calsokk/Sound_LED_PCB/sound_led_project.kicad_pcb

## KiCad design sound_led_project.kicad_pcb (2024-12-28)

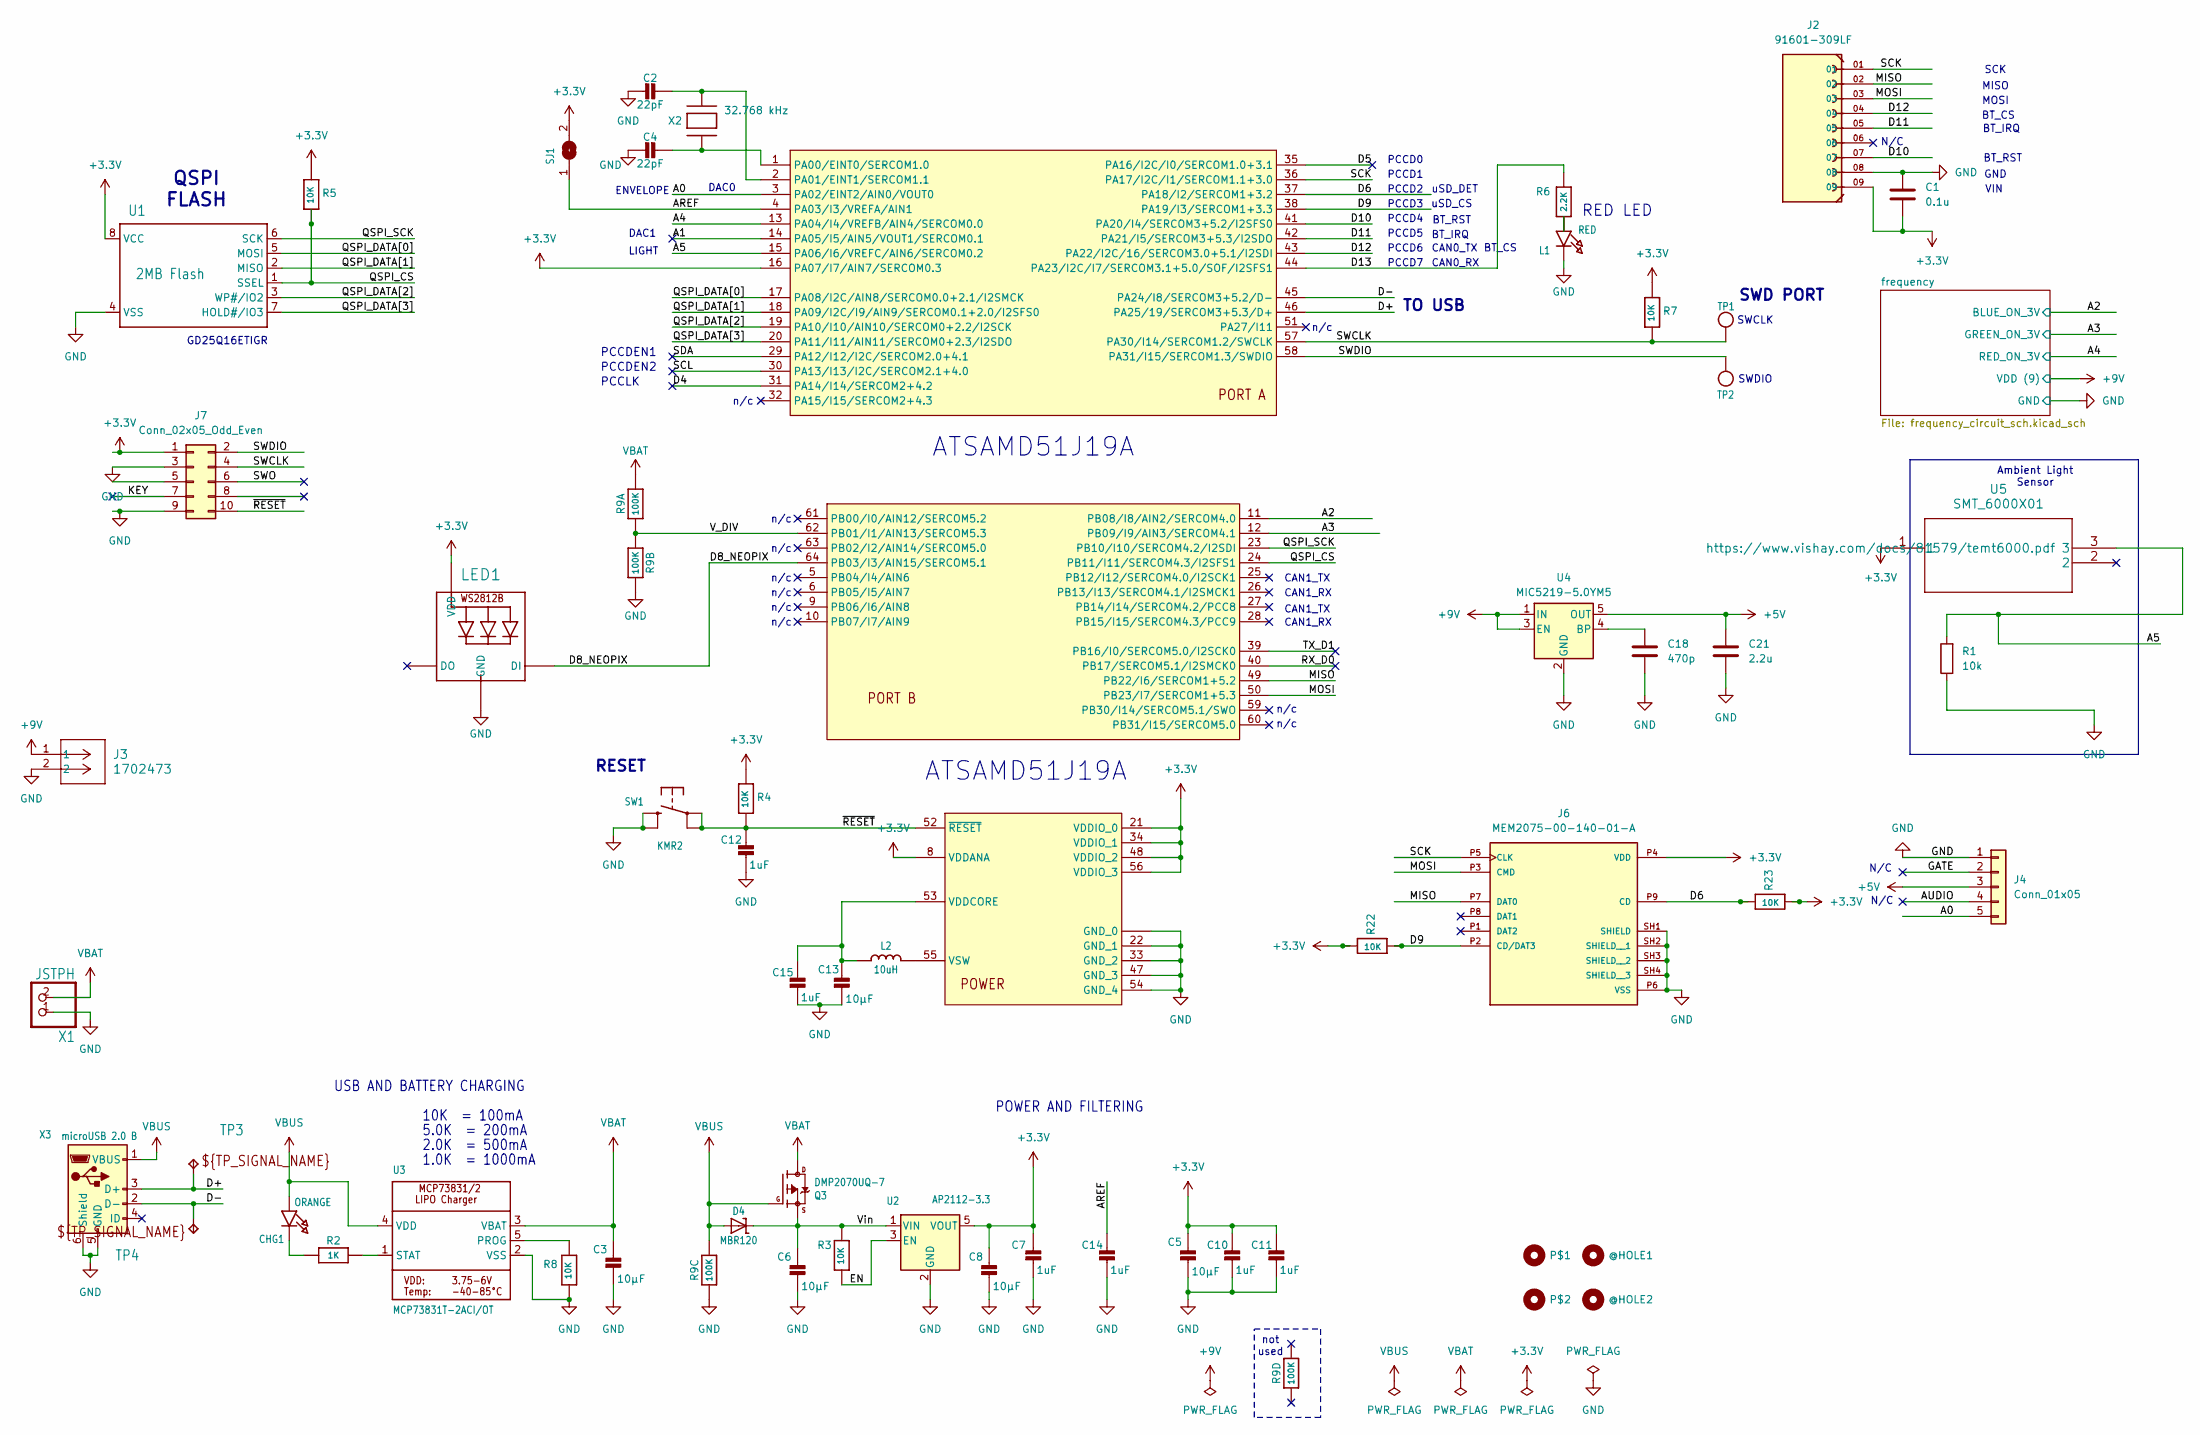
[picture p3: schematic sound_led_project.kicad_sch, feather M4 express]

Parts:
@HOLE1, @HOLE2: MountingHole; MountingHole_2.5mm
C1: 0.1u; C_0402_1005Metric_Pad0.74x0.62mm_HandSolder; Mfr P/N CL05B104KP5NNNC
C2, C4: 22pF; 0603-NO; Mfr P/N C0603C220K4GAC7867
C3, C5, C6, C8, C13: 10µF; 0805-NO; Mfr P/N CL21A106KOQNNNE
C7, C10, C11, C12, C14, C15: 1uF; C_0603_1608Metric_Pad1.08x0.95mm_HandSolder; Mfr P/N CC0603KRX7R7BB105
C18: 470p; C_0402_1005Metric_Pad0.74x0.62mm_HandSolder; Mfr P/N GRM155R71H471KA01D
C21: 2.2u; C_0201_0603Metric; Mfr P/N CL10A225KO8NNNC
CHG1: ORANGE; CHIPLED_0805_NOOUTLINE; Mfr P/N B1701UD--20D000414U1930
D4: MBR120; SOD-123; Mfr P/N MBR120LSFT1G
J2: 91601-309LF; AMPHENOL_91601-309LF; PARTREV AJ
J3: 1702473; Mfr P/N 1702473
J4: Conn_01x05; GCT_BG125-05-A-1-1-0440-N-D-TOP; Mfr P/N BG125-05-A-1-1-0440-N-D
J6: MEM2075-00-140-01-A; GCT_MEM2075-00-140-01-A; PARTREV A
J7: Conn_02x05_Odd_Even; AMPHENOL_20021521-00010T4LF; Mfr P/N 20021521-00010T4LF
L1: RED; CHIPLED_0805_NOOUTLINE; Mfr P/N LTST-S220KRKT
L2: 10uH; INDUCTOR_1007; Mfr P/N LSQEA251818T100K
LED1: WS2812B3535; LED3535; Mfr P/N SK6812MINI
P$1, P$2: MountingHole; MOUNTINGHOLE_2.5_PLATED
Q3: DMP2070UQ-7; SOT23-R; Mfr P/N DMP2070UQ-7
R1: 10k; R_0805_2012Metric_Pad1.20x1.40mm_HandSolder; Mfr P/N ERJ-U06D1002V
R2: 1K; 0603-NO; Mfr P/N MCT06030C1001FP500
R3, R4, R5, R7, R8, R22, R23: 10K; 0603-NO; Mfr P/N RNCP0603FTD10K0
R6: 2.2K; 0603-NO; Mfr P/N CRGH0603F2K2
R9: 100K; R_Array_Convex_4x0603; Mfr P/N CAY16-1003F4LF
SJ1: SOLDERJUMPERCLOSED; SOLDERJUMPER_CLOSEDWIRE
SW1: KMR2; BTN_KMR2_4.6X2.8; Mfr P/N KMR241NG ULC LFS
TP1, TP2: TESTPOINTROUND1.5MM; TESTPOINT_ROUND_1.5MM
TP3, TP4: B1,27_385
U1: 2MB Flash; SOIC-8_3.9x4.9mm_P1.27mm; Mfr P/N GD25Q16ETIGR
U2: AP2112-3.3; SOT-23-5; Mfr P/N AP2112K-3.3TRG1
U3: MCP73831T-2ACI/OT; SOT23-5; Mfr P/N MCP73831T-2ATI/OT
U4: MIC5219-5.0YM5; SOT-23-5; Mfr P/N MIC5219-5.0YM5-TR
U5: SMT_6000X01; TEMT6000X01; Mfr P/N TEMT6000X01
U$1: ATSAMD51J19A-AUT; TQFP-64_10x10mm_P0.5mm; Mfr P/N ATSAMD51J19A-AUT
X1: JSTPH; JST_PH_S2B-PH-SM4-TB_1x02-1MP_P2.00mm_Horizontal; Mfr P/N S2B-PH-SM4-TB
X2: 32.768 kHz; XTAL3215; Mfr P/N STDMUA17-32.768K
X3: microUSB 2.0 B; USB_Micro-B_Amphenol_10118194_Horizontal; Mfr P/N 10118194-0001LF

Connections:
+3.3V: C1.2, C5.1, C7.1, C8.1, C10.1, C11.1, J2.09, J6.P4 (VDD), J7.1, LED1.2 (VDD), R4.1, R5.1, R7.1, R22.1, R23.2, SJ1.2, U1.8 (VCC), U2.5 (VOUT), U5.1, U$1.8 (VDDANA), U$1.16 (PA07/I7/AIN7/SERCOM0.3), U$1.21 (VDDIO_0), U$1.34 (VDDIO_1), U$1.48 (VDDIO_2), U$1.56 (VDDIO_3)
+5V: C21.1, J4.3, U4.5 (OUT)
+9V: J3.1, U4.1 (IN), U4.3 (EN); also elsewhere on the board
/A0: J4.5, U$1.3 (PA02/EINT2/AIN0/VOUT0)
/A1: U$1.14 (PA05/I5/AIN5/VOUT1/SERCOM0.1)
/A2: U$1.11 (PB08/I8/AIN2/SERCOM4.0); also elsewhere on the board
/A3: U$1.12 (PB09/I9/AIN3/SERCOM4.1); also elsewhere on the board
/A4: U$1.13 (PA04/I4/VREFB/AIN4/SERCOM0.0); also elsewhere on the board
/A5: R1.2, U5.3, U$1.15 (PA06/I6/VREFC/AIN6/SERCOM0.2)
/AREF: C14.1, SJ1.1, U$1.4 (PA03/I3/VREFA/AIN1)
/AUDIO: J4.4
/D4: U$1.31 (PA14/I14/SERCOM2+4.2)
/D5: U$1.35 (PA16/I2C/I0/SERCOM1.0+3.1)
/D6: J6.P9 (CD), R23.1, U$1.37 (PA18/I2/SERCOM1+3.2)
/D8_NEOPIX: LED1.1 (DI), U$1.64 (PB03/I3/AIN15/SERCOM5.1)
/D9: J6.P2 (CD/DAT3), R22.2, U$1.38 (PA19/I3/SERCOM1+3.3)
/D10: J2.07, U$1.41 (PA20/I4/SERCOM3+5.2/I2SFS0)
/D11: J2.05, U$1.42 (PA21/I5/SERCOM3+5.3/I2SDO)
/D12: J2.04, U$1.43 (PA22/I2C/16/SERCOM3.0+5.1/I2SDI)
/D13: R6.1, U$1.44 (PA23/I2C/I7/SERCOM3.1+5.0/SOF/I2SFS1)
/D+: TP3.TP, U$1.46 (PA25/19/SERCOM3+5.3/D+), X3.3 (D+)
/D-: TP4.TP, U$1.45 (PA24/I8/SERCOM3+5.2/D-), X3.2 (D-)
/EN: R3.2, U2.3 (EN)
/GATE: J4.2
/KEY: J7.7
/MISO: J2.02, J6.P7 (DAT0), U$1.49 (PB22/I6/SERCOM1+5.2)
/MOSI: J2.03, J6.P3 (CMD), U$1.50 (PB23/I7/SERCOM1+5.3)
/QSPI_CS: R5.2, U1.1 (SSEL), U$1.24 (PB11/I11/SERCOM4.3/I2SFS1)
/QSPI_DATA[0]: U1.5 (MOSI), U$1.17 (PA08/I2C/AIN8/SERCOM0.0+2.1/I2SMCK)
/QSPI_DATA[1]: U1.2 (MISO), U$1.18 (PA09/I2C/I9/AIN9/SERCOM0.1+2.0/I2SFS0)
/QSPI_DATA[2]: U1.3 (WP#/IO2), U$1.19 (PA10/I10/AIN10/SERCOM0+2.2/I2SCK)
/QSPI_DATA[3]: U1.7 (HOLD#/IO3), U$1.20 (PA11/I11/AIN11/SERCOM0+2.3/I2SDO)
/QSPI_SCK: U1.6 (SCK), U$1.23 (PB10/I10/SERCOM4.2/I2SDI)
/RX_D0: U$1.40 (PB17/SERCOM5.1/I2SMCK0)
/SCK: J2.01, J6.P5 (CLK), U$1.36 (PA17/I2C/I1/SERCOM1.1+3.0)
/SCL: U$1.30 (PA13/I13/I2C/SERCOM2.1+4.0)
/SDA: U$1.29 (PA12/I12/I2C/SERCOM2.0+4.1)
/SWCLK: J7.4, R7.2, TP1.P$1, U$1.57 (PA30/I14/SERCOM1.2/SWCLK)
/SWDIO: J7.2, TP2.P$1, U$1.58 (PA31/I15/SERCOM1.3/SWDIO)
/SWO: J7.6
/TX_D1: U$1.39 (PB16/I0/SERCOM5.0/I2SCK0)
/V_DIV: R9.1, R9.2 (1), U$1.62 (PB01/I1/AIN13/SERCOM5.3)
/Vin: C6.1, D4.C, Q3.2 (S), R3.1, U2.1 (VIN)
/~RESET: C12.1, J7.10, R4.2, SW1.A, SW1.A' (P1), U$1.52 (~RESET)
GND: C1.1, C2.2, C3.2, C4.2, C5.2, C6.2, C7.2, C8.2, C10.2, C11.2, C12.2, C13.2, C14.2, C15.2, C18.2, C21.2, J2.08, J3.2, J4.1, J6.P6 (VSS), J6.SH1 (SHIELD), J6.SH2 (SHIELD__1), J6.SH3 (SHIELD__2), J6.SH4 (SHIELD__3), J7.3, J7.9, L1.C, LED1.4 (GND), R1.1, R8.2, R9.3 (1), R9.7 (2), SW1.B (S), SW1.B' (S1), U1.4 (VSS), U2.2 (GND), U3.2 (VSS), U4.2 (GND), U$1.7 (GND_0), U$1.22 (GND_1), U$1.33 (GND_2), U$1.47 (GND_3), U$1.54 (GND_4), X1.1, X3.5 (GND), X3.6 (Shield); also elsewhere on the board
unnamed: CHG1.C, R2.1
unnamed: L1.A, R6.2
unnamed: C13.1, C15.1, L2.P$1 (1), U$1.53 (VDDCORE)
unnamed: L2.P$2 (2), U$1.55 (VSW)
unnamed: R8.1, U3.5 (PROG)
unnamed: R2.2, U3.1 (STAT)
unnamed: C18.1, U4.4 (BP)
unnamed: C4.1, U$1.1 (PA00/EINT0/SERCOM1.0), X2.P$1
unnamed: C2.1, U$1.2 (PA01/EINT1/SERCOM1.1), X2.P$2
VBAT: C3.1, Q3.3 (D), R9.8 (2), U3.3 (VBAT), X1.2
VBUS: CHG1.A, D4.A, Q3.1 (G), R9.6 (2), U3.4 (VDD), X3.1 (VBUS)

Notes on the sheet:
n/c
MISO
SCK
SWCLK
ATSAMD51J19A
USB AND BATTERY CHARGING
PCCD6
Ambient Light Sensor
RED LED
DAC1
CAN0_TX
PCCLK
SWDIO
PCCD5
10K = 100mA
BT_RST
CAN1_TX
TO USB
N/C
PCCD3
5.0K = 200mA
uSD_CS
uSD_DET
PCCD2
GD25Q16ETIGR
1.0K = 1000mA
2.0K = 500mA
GND
BT_CS
PCCD1
CAN1_RX
DAC0
LIGHT
VIN
MOSI
CAN0_RX
PCCD0
ENVELOPE
PCCD7
QSPI FLASH
PCCDEN1
BT_IRQ
SWD PORT
RESET
POWER AND FILTERING
PCCDEN2
not used
PCCD4

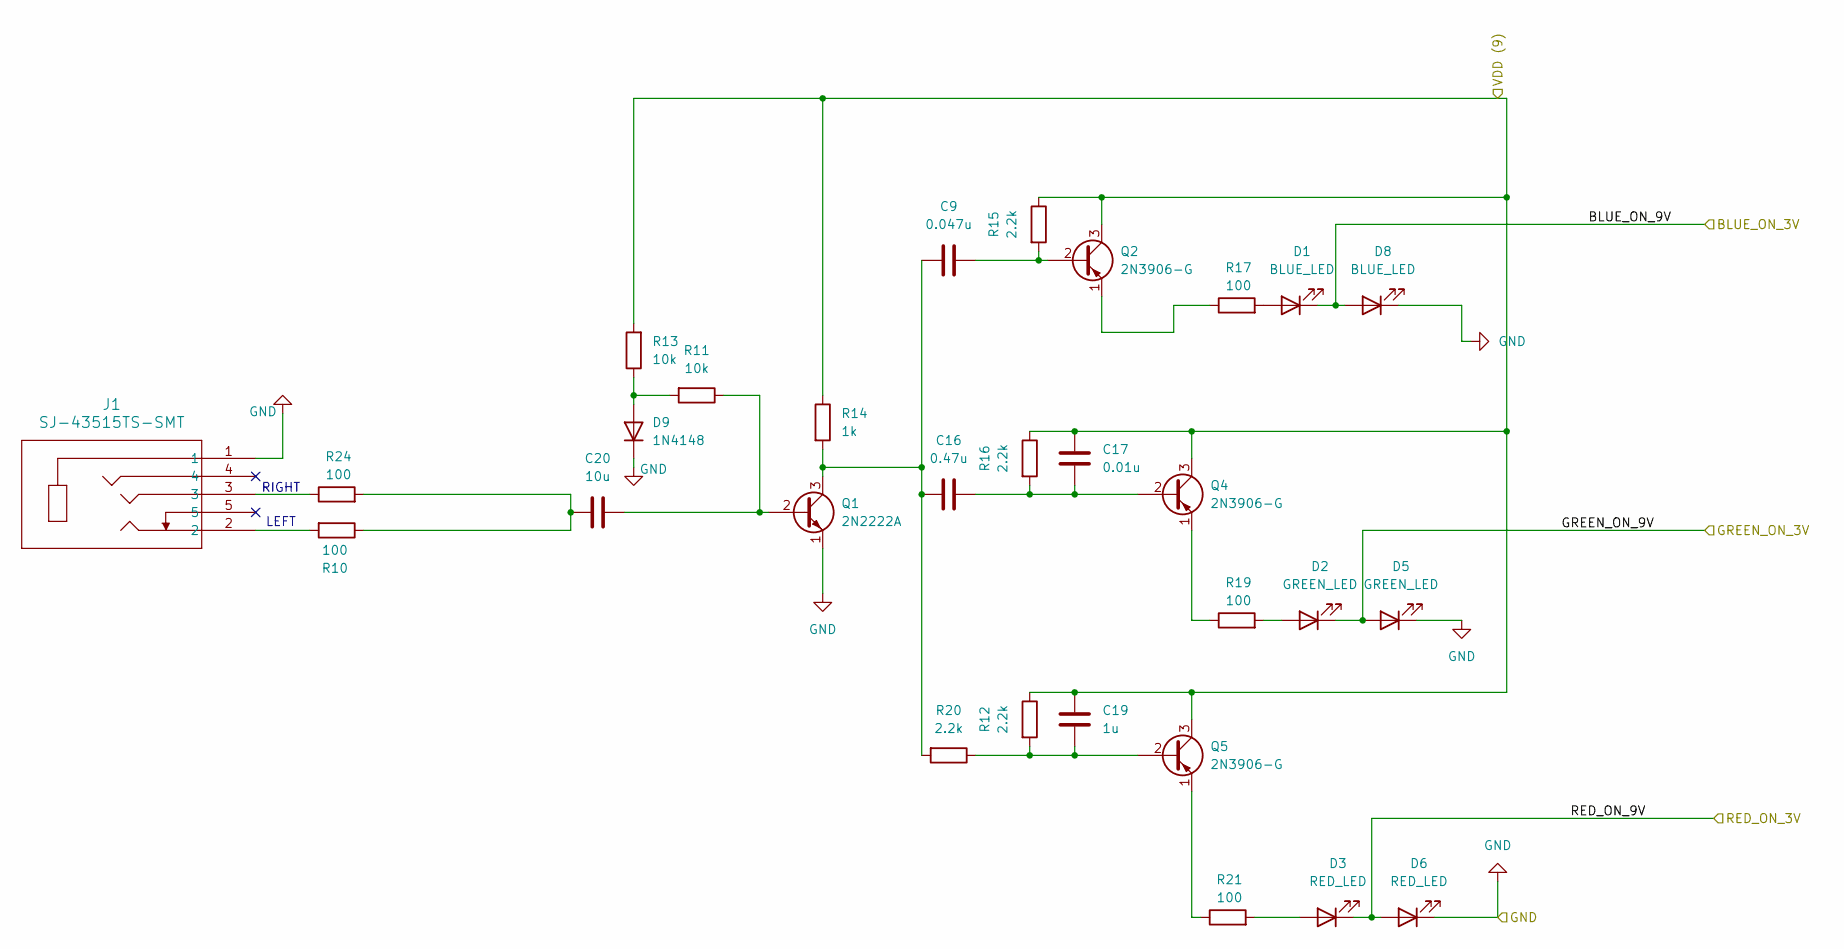
[picture p4: schematic frequency_circuit_sch.kicad_sch]

Parts:
C9: 0.047u; C_0402_1005Metric_Pad0.74x0.62mm_HandSolder; Mfr P/N GRM155R71E473KA88D
C16: 0.47u; C_0805_2012Metric_Pad1.18x1.45mm_HandSolder; Mfr P/N CL21B474KBFNNNG
C17: 0.01u; C_0201_0603Metric_Pad0.64x0.40mm_HandSolder; Mfr P/N GMD033R61A103KA01D
C19: 1u; C_0402_1005Metric_Pad0.74x0.62mm_HandSolder; Mfr P/N MAASL105CD7105MFCA01
C20: 10u; C_0805_2012Metric_Pad1.18x1.45mm_HandSolder; Mfr P/N CL21A106KOQNNNE
D1: BLUE_LED; LED_D5.0mm; Mfr P/N 151031SS06000
D2, D5: GREEN_LED; LED_D3.0mm; Mfr P/N 151031VS06000
D3, D6: RED_LED; LED_D3.0mm; Mfr P/N 151031SS06000
D8: BLUE_LED; LED_D5.0mm; Mfr P/N 151051BS04000
D9: 1N4148; D_DO-35_SOD27_P7.62mm_Horizontal; Mfr P/N 1N4148W-HG3_A-08
J1: SJ-43515TS-SMT; SJ-43515TS-SMT_CUD; Mfr P/N SJ-43515TS-SMT-TR
Q1: 2N2222A; TO92254P470H750-3; Mfr P/N 2N2222A
Q2, Q4, Q5: 2N3906-G; TO92127P470H495-3; Mfr P/N 2N3906-G
R10, R17, R19, R21, R24: 100; R_0603_1608Metric_Pad0.98x0.95mm_HandSolder; Mfr P/N Mfr. Part # ERJ-P03F1000V
R11, R13: 10k; R_0805_2012Metric_Pad1.20x1.40mm_HandSolder; Mfr P/N ERJ-U06D1002V
R12, R15, R16, R20: 2.2k; C_0201_0603Metric_Pad0.64x0.40mm_HandSolder; Mfr P/N ERJ-1GJF2201C
R14: 1k; R_0402_1005Metric_Pad0.72x0.64mm_HandSolder; Mfr P/N ERA-2ARC102X

Connections:
+9V: C17.1, C19.1, Q2.3 (C), Q4.3 (C), Q5.3 (C), R12.1, R13.2, R14.1, R15.1, R16.1; also elsewhere on the board
/A2: D1.1 (K), D8.2 (A); also elsewhere on the board
/A3: D2.1 (K), D5.2 (A); also elsewhere on the board
/A4: D3.1 (K), D6.2 (A); also elsewhere on the board
GND: D5.1 (K), D6.1 (K), D8.1 (K), D9.1 (K), J1.1, Q1.1 (E); also elsewhere on the board
unnamed: C20.1, R10.1, R24.2
unnamed: D1.2 (A), R17.2
unnamed: D2.2 (A), R19.2
unnamed: D3.2 (A), R21.2
unnamed: D9.2 (A), R11.2, R13.1
unnamed: J1.2, R10.2
unnamed: J1.3, R24.1
unnamed: C20.2, Q1.2 (B), R11.1
unnamed: C9.1, C16.1, Q1.3 (C), R14.2, R20.2
unnamed: C9.2, Q2.2 (B), R15.2
unnamed: Q2.1 (E), R17.1
unnamed: C16.2, C17.2, Q4.2 (B), R16.2
unnamed: Q4.1 (E), R19.1
unnamed: C19.2, Q5.2 (B), R12.2, R20.1
unnamed: Q5.1 (E), R21.1

Notes on the sheet:
LEFT
RIGHT

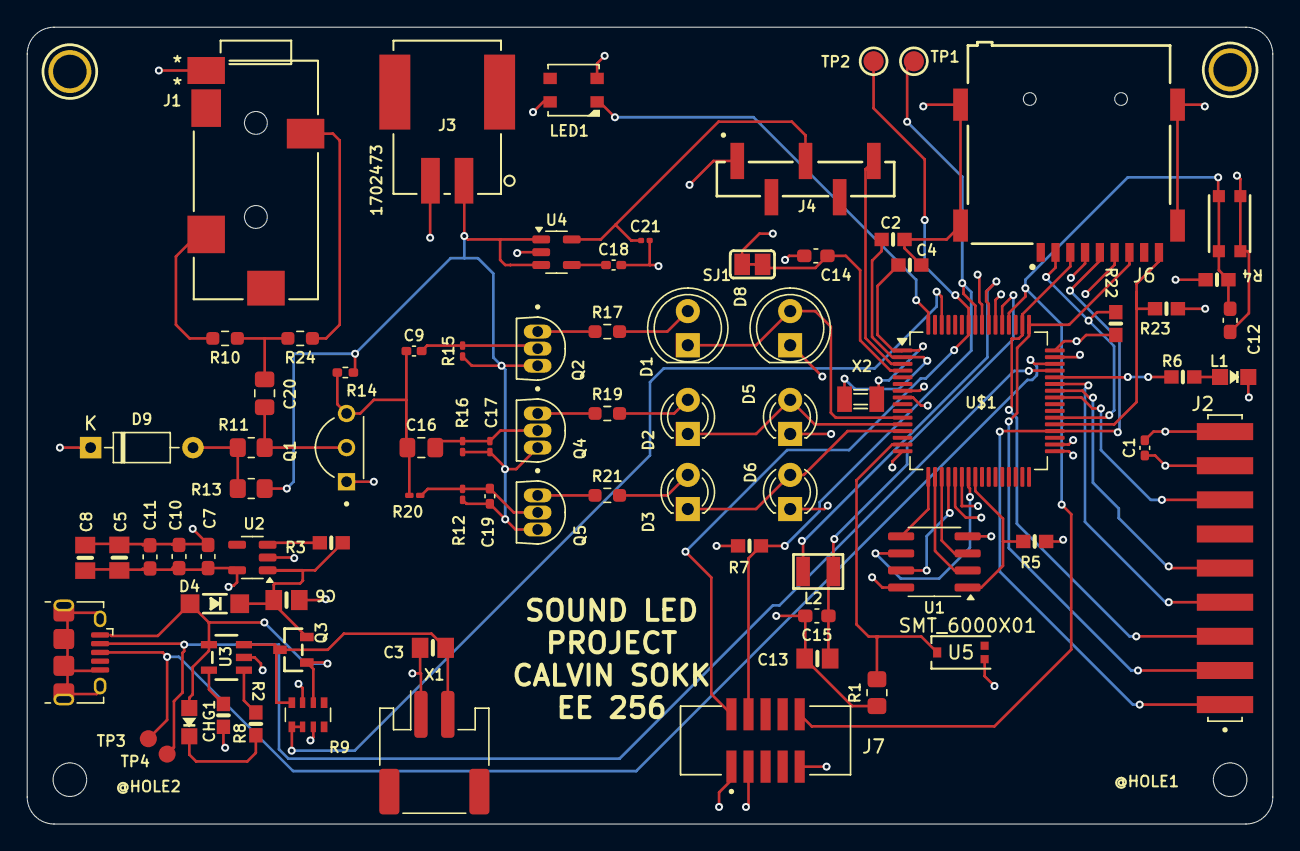
[picture p5: board sound_led_project.kicad_pcb from above]

Board: 4 copper layers, 92.7 x 59.3 mm, 86 parts (0 on the bottom side), 60 nets.
